devcexx/chiquito/images/chiquito_pinout.png

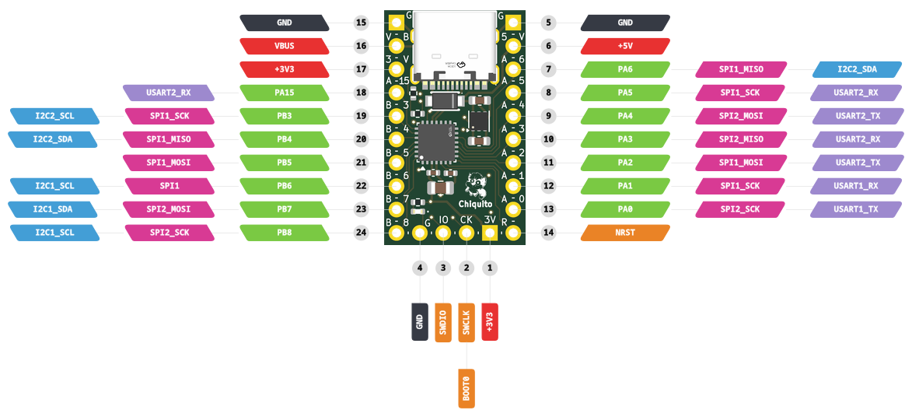
images/chiquito_pinout.png
