devcexx/chiquito/production/bom.csv

Designator | Footprint | Quantity | Value | LCSC Part #
C1 | 0805 | 1 | 4.7u | C1779
C2, C5 | 0402 | 2 | 100n | C1525
C3, C4 | 0603 | 2 | 4.7u | C19666
D1 | SOD-123F_L2.8-W1.8-LS3.7-RD | 1 | MBR120VLSFT1G | C223608
D2 | 0402 | 1 | LED | C130724
R1, R2 | 0402 | 2 | 5k1 | C25905
R3 | 0402 | 1 | 1k5
U2 | WSON-6-1EP_2x2mm_P0.65mm_EP1x1.6mm | 1 | TLV75733PDRV | C2868428
U3 | QFN-28_4x4mm_P0.5mm | 1 | STM32C071G8U6 | C44521811
USB1 | USB-C-SMD_HANELECTRICITY_161N-4XVS11 | 1 | 161N-4PVS11 | C5440757
