devcexx/chiquito/chiquito.kicad_pcb

## KiCad design chiquito.kicad_pcb (2026-10-28)

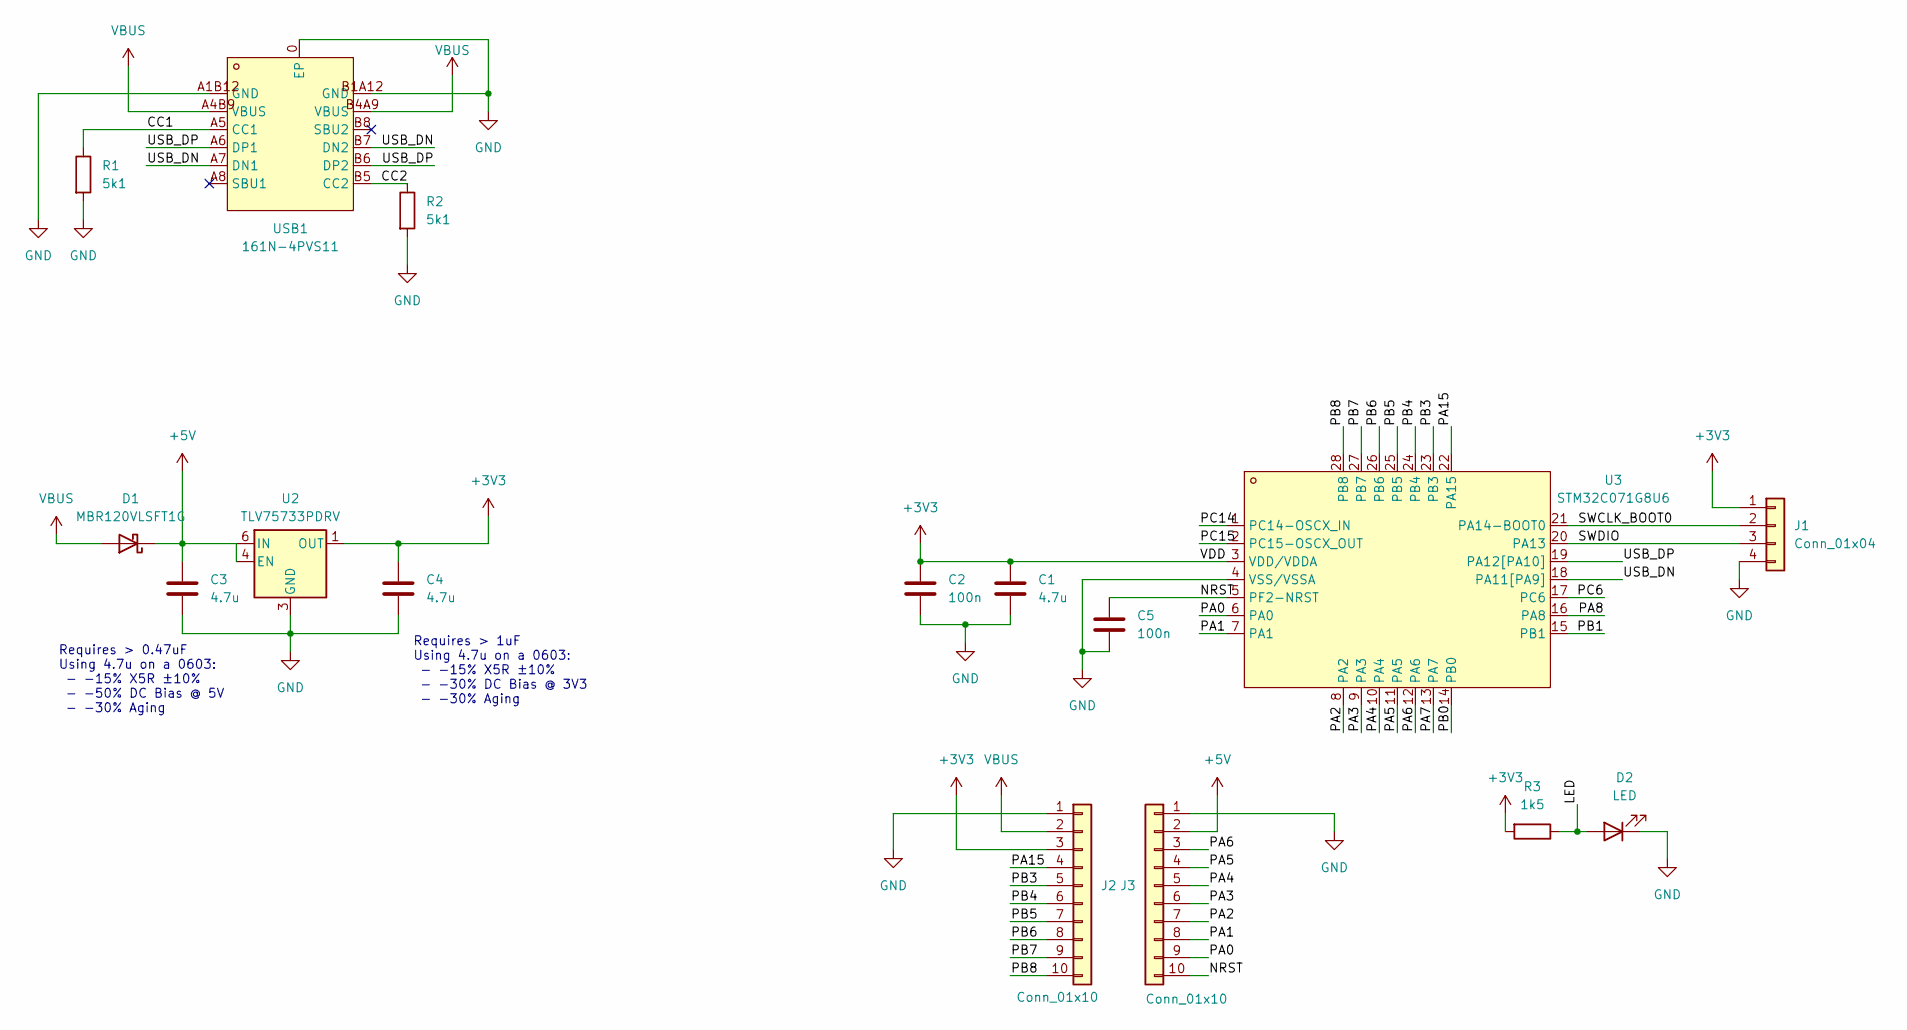
[picture p3: schematic chiquito.kicad_sch]

Parts:
C1: 4.7u; C_0805_2012Metric; LCSC C1779
C2, C5: 100n; C_0402_1005Metric; LCSC C1525
C3, C4: 4.7u; C_0603_1608Metric; LCSC C19666
D1: MBR120VLSFT1G; SOD-123F_L2.8-W1.8-LS3.7-RD; LCSC C191023
D2: LED; LED_0402_1005Metric; LCSC C130724
J1: Conn_01x04; PinHeader_1x04_P2.54mm_Vertical_Slim
J2, J3: Conn_01x10; PinHeader_1x10_P2.54mm_Vertical_Slim
R1, R2: 5k1; R_0402_1005Metric; LCSC C25905
R3: 1k5; R_0402_1005Metric
U2: TLV75733PDRV; WSON-6-1EP_2x2mm_P0.65mm_EP1x1.6mm; LCSC C2868428
U3: STM32C071G8U6; QFN-28_4x4mm_P0.5mm; MPN STM32C071G8U6; LCSC Part C44521811
USB1: 161N-4PVS11; USB-C-SMD_HANELECTRICITY_161N-4XVS11; MPN 161N-4PVS11; LCSC Part C5440757

Connections:
+3V3: C1.1, C2.1, C4.1, J1.1, J2.3, R3.2, U2.1 (OUT), U3.3 (VDD/VDDA)
+5V: C3.1, D1.1 (K), J3.2, U2.4 (EN), U2.6 (IN)
/CC1: R1.1, USB1.A5 (CC1)
/CC2: R2.1, USB1.B5 (CC2)
/LED: D2.2 (A), R3.1
/NRST: C5.1, J3.10, U3.5 (PF2-NRST)
/PA0: J3.9, U3.6 (PA0)
/PA1: J3.8, U3.7 (PA1)
/PA2: J3.7, U3.8 (PA2)
/PA3: J3.6, U3.9 (PA3)
/PA4: J3.5, U3.10 (PA4)
/PA5: J3.4, U3.11 (PA5)
/PA6: J3.3, U3.12 (PA6)
/PA7: U3.13 (PA7)
/PA8: U3.16 (PA8)
/PA15: J2.4, U3.22 (PA15)
/PB0: U3.14 (PB0)
/PB1: U3.15 (PB1)
/PB3: J2.5, U3.23 (PB3)
/PB4: J2.6, U3.24 (PB4)
/PB5: J2.7, U3.25 (PB5)
/PB6: J2.8, U3.26 (PB6)
/PB7: J2.9, U3.27 (PB7)
/PB8: J2.10, U3.28 (PB8)
/PC6: U3.17 (PC6)
/PC14: U3.1 (PC14-OSCX_IN)
/PC15: U3.2 (PC15-OSCX_OUT)
/SWCLK_BOOT0: J1.2, U3.21 (PA14-BOOT0)
/SWDIO: J1.3, U3.20 (PA13)
/USB_DN: U3.18 (PA11[PA9]), USB1.A7 (DN1), USB1.B7 (DN2)
/USB_DP: U3.19 (PA12[PA10]), USB1.A6 (DP1), USB1.B6 (DP2)
GND: C1.2, C2.2, C3.2, C4.2, C5.2, D2.1 (K), J1.4, J2.1, J3.1, R1.2, R2.2, U2.3 (GND), U2.7 (GND), U3.4 (VSS/VSSA), USB1.0 (EP), USB1.A1B12 (GND), USB1.B1A12 (GND)
VBUS: D1.2 (A), J2.2, USB1.A4B9 (VBUS), USB1.B4A9 (VBUS)

Notes on the sheet:
Requires > 0.47uF Using 4.7u on a 0603: - -15% X5R ±10% - -50% DC Bias @ 5V - -30% Aging
Requires > 1uF Using 4.7u on a 0603: - -15% X5R ±10% - -30% DC Bias @ 3V3 - -30% Aging

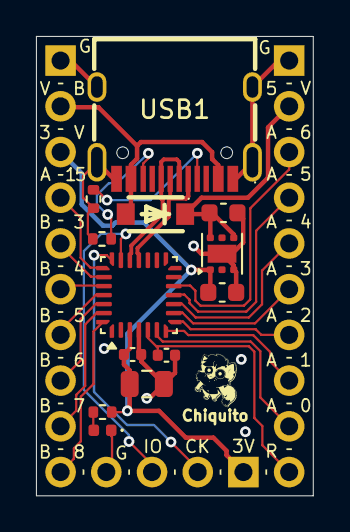
[picture p4: board chiquito.kicad_pcb from above]

Board: 4 copper layers, 15.4 x 25.5 mm, 16 parts (0 on the bottom side), 26 nets.
